chris3069/Grossprojekt_Foehn/README.md

# Großprojekt Föhn

Für das Fritz-Felsenstein-Haus aus Königsbrunn wurde das bestehende Projekt **Föhn** erweitert und verbessert. 
Der Föhn ermöglicht Rollstuhlfahrern und gehbehinderte Personen und Kindern sich selbständig die Haare zu föhnen. 

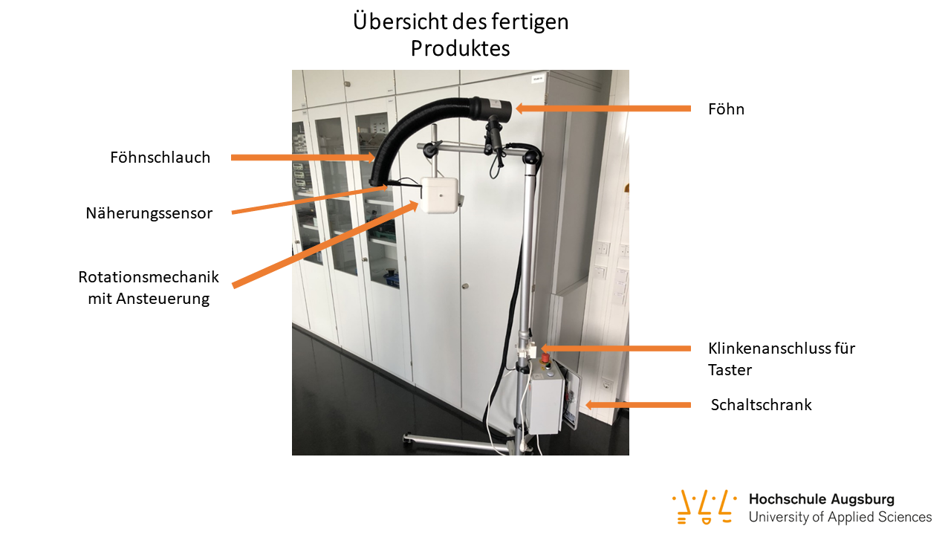
[picture p1: Dokumentation/Abschlusspräsentation Föhn 21/Folie6.PNG]
Föhn Übersicht


## Projektübernahme 
Die Vorgängergruppe hat den Föhn mit einem Raspberry Pi gesteuert. Die lange Vorbereitungszeit bis das System bereit war, hat zu lange gedauert. \
Es konnte nicht eingesetzt werden, da es nicht den geltenden EMV-Bestimmungen entsprach. Die Software des Föhns hatte Fehler und konnte nach wenigen Minuten nicht wieder benutzt werden. 

## Projektziele

- Requirements Engineering um Anforderungen und Projektziel besser abzustimmen. 
- Lasten- und Pflichtenheft erstellen 
- Austausch der Steuerung durch ein uController, STM32F446RE um Vorbereitungszeit zu verringern 
- Sicherer störungsfreier und konstanter Föhnbetrieb
- Universelle HMI-Schnittstelle um Taster austauschen zu können
- Drehbewegung des Föhns um gleichmäßiges Föhnen zu ermöglichen und Brandstellen zu vermeiden
- Bessere Sensorik verwenden 

## Software

Die Initialisierung wurde die CubeMx generiert. Die Software wurde mithilfe des STM HAL geschrieben. 

Die Software wurde mithilfe von UML Diagrammen dokumentiert. 
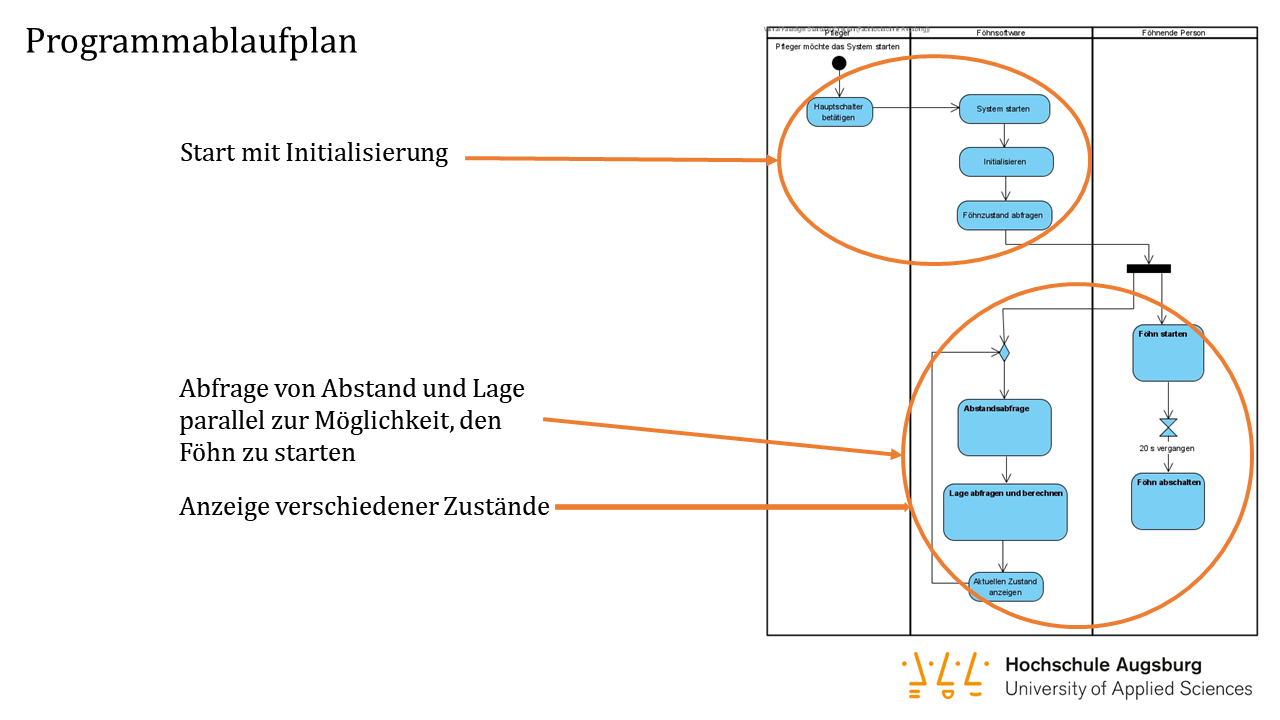
[picture p2: Dokumentation/Abschlusspräsentation Föhn 21/Folie10.PNG]
UML Diagramm Programmablaufplan
Eines der wichtigsten Diagramme zeigt den Programmablaufplan. 

## Motoransteuerung 

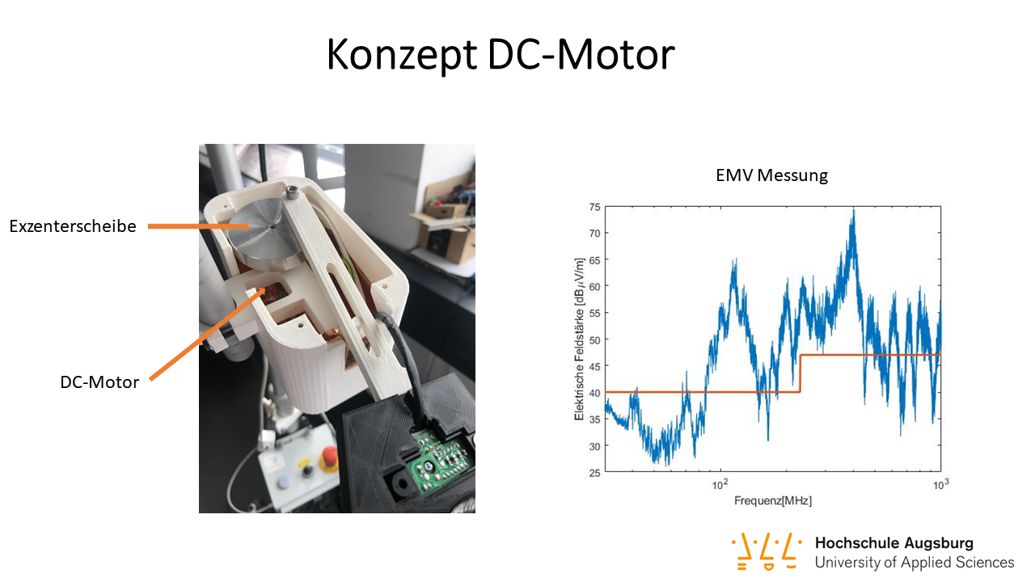
[picture p3: Dokumentation/Abschlusspräsentation Föhn 21/Folie13.PNG]
DC-Motor
Eine Anforderung der Leitung war einen DC-Motor zu verwenden. Es wurde eine Mechanik und auch eine elektrische sowie Software Ansteuerung entwickelt. 
Die EMV Werte lagen über den erlaubten Grenzwerten. Es wurde eine Lösung mithilfe eines Servo-Motors gewählt. Die EMV-Messwerte lagen danach unterhalb der Grenzwerte. 
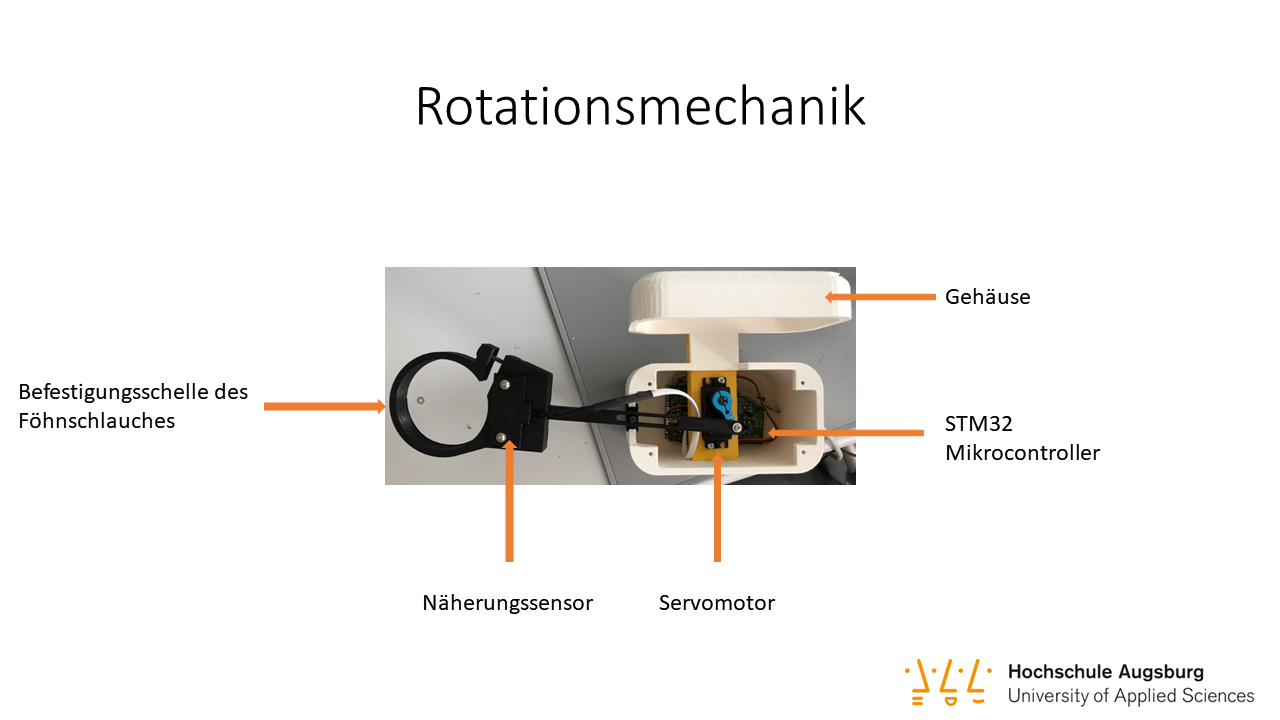
[picture p4: Dokumentation/Abschlusspräsentation Föhn 21/Folie7.PNG]
Servo-Motor


## Zeitungsartikel
Auch in der Zeitung wurde über das Projekt und den Föhn berichtet. 

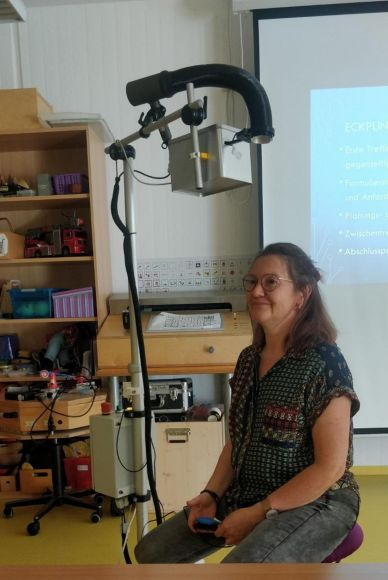
[picture p5: Dokumentation/Foehn_Anwendung.png]
Föhn Anwendung


[Staz Zeitungsartikel](https://www.staz.de/region/koenigsbrunn/lokales/tastern-mikrocomputern-studenten-entwickeln-spiele-alltagsgegenstaende-fuer-koerperbehinderte-id231747.html)
