chris3069/Grossprojekt_Foehn/Dokumentation/UML-Diagramme/README.md

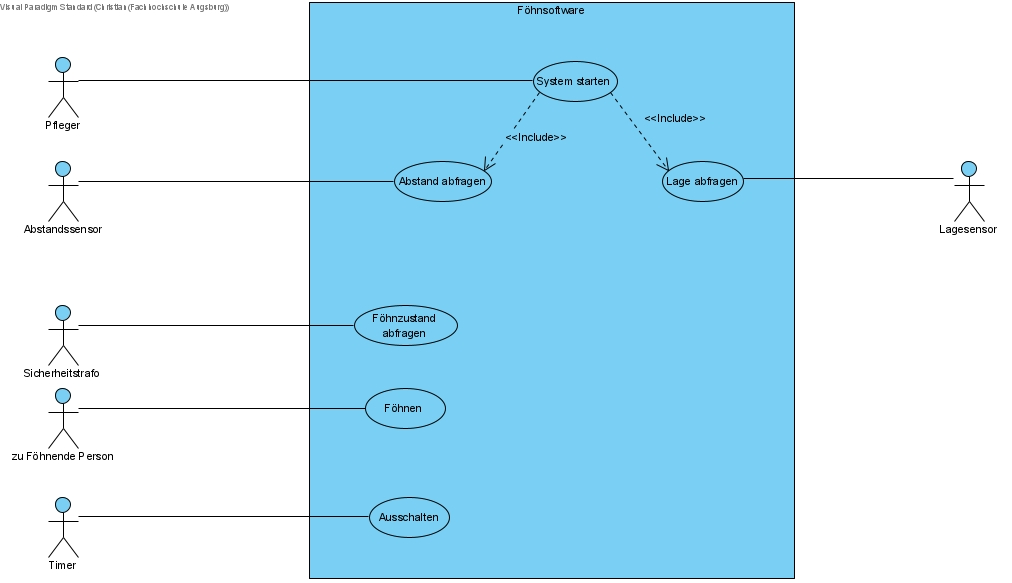
[picture p6: Dokumentation/UML-Diagramme/Use_Case_Diagramm_Foehn.jpg]
Use Case Diagramm


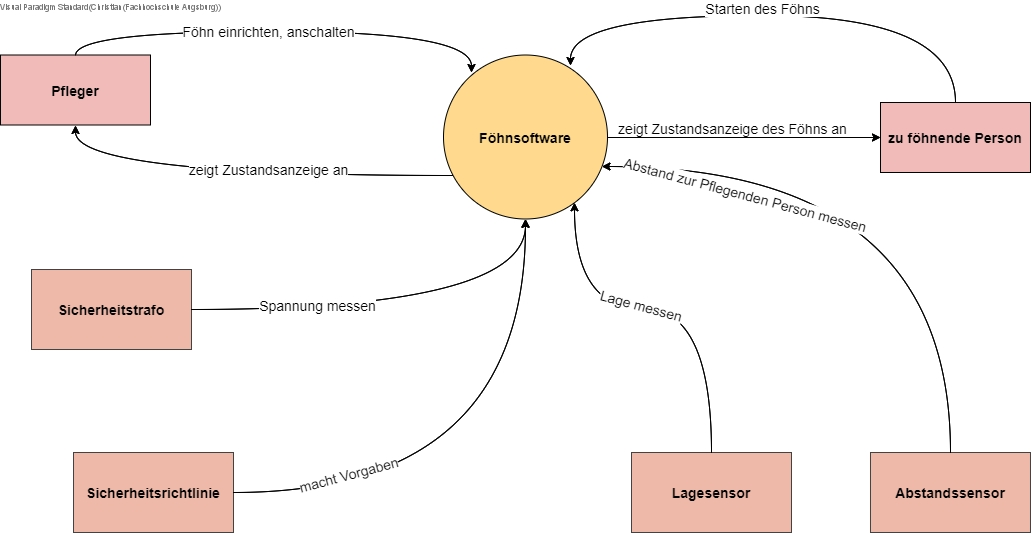
[picture p7: Dokumentation/UML-Diagramme/Kontextdiagramm.jpg]
Kontextdiagramm


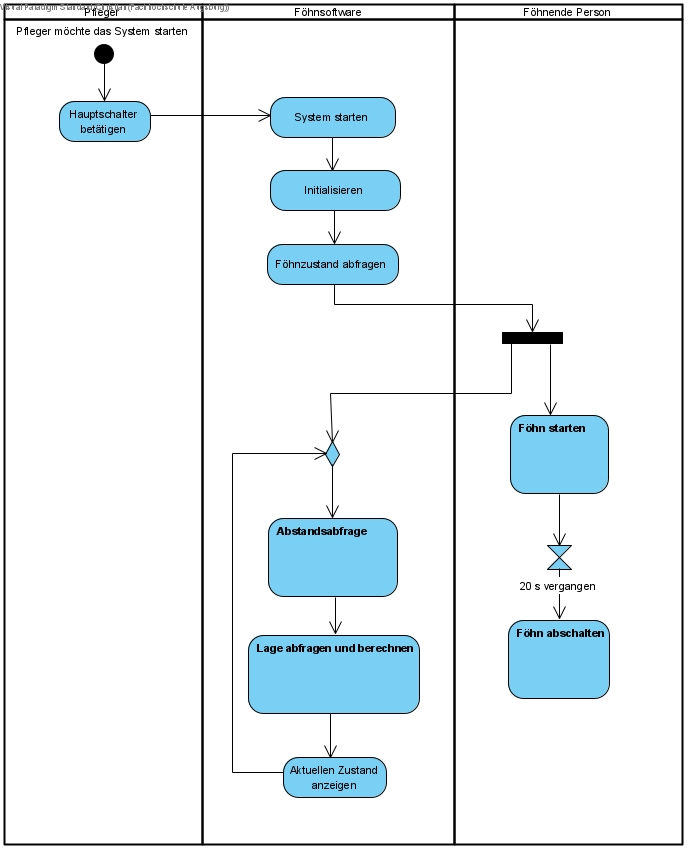
[picture p8: Dokumentation/UML-Diagramme/Aktivitaetsdiagramm_main.jpg]
Main Loop Aktivitaetsdiagramm


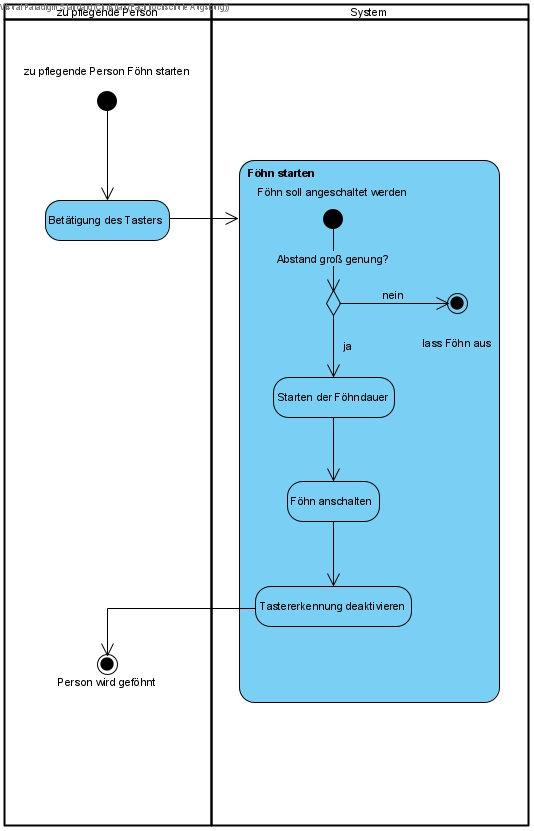
[picture p9: Dokumentation/UML-Diagramme/Aktivitaetsdiagramm_Foehn_starten.jpg]
Foehn starten Aktivitaetsdiagramm


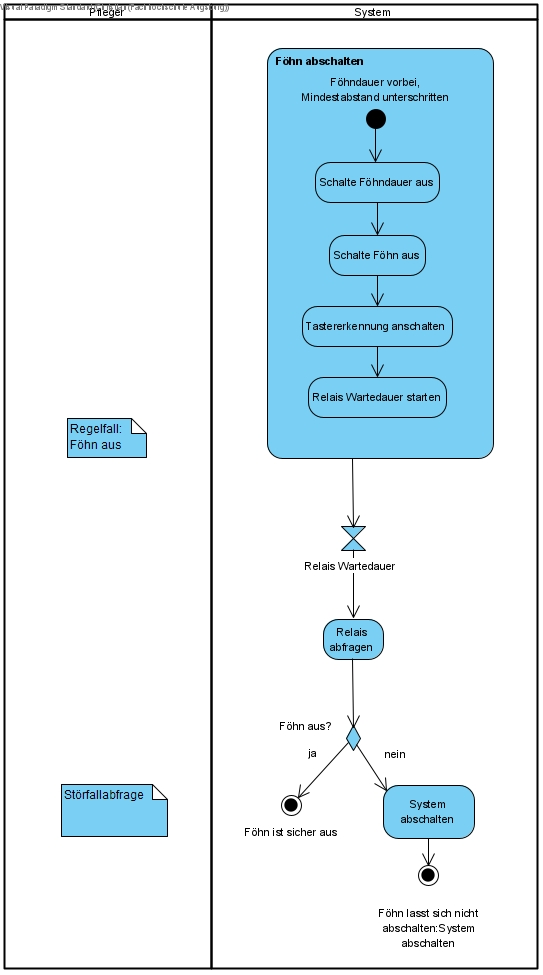
[picture p10: Dokumentation/UML-Diagramme/Aktivitätsdiagramm_Foehn_Abschalten.jpg]
Foehn abschalten Aktivitaetsdiagramm


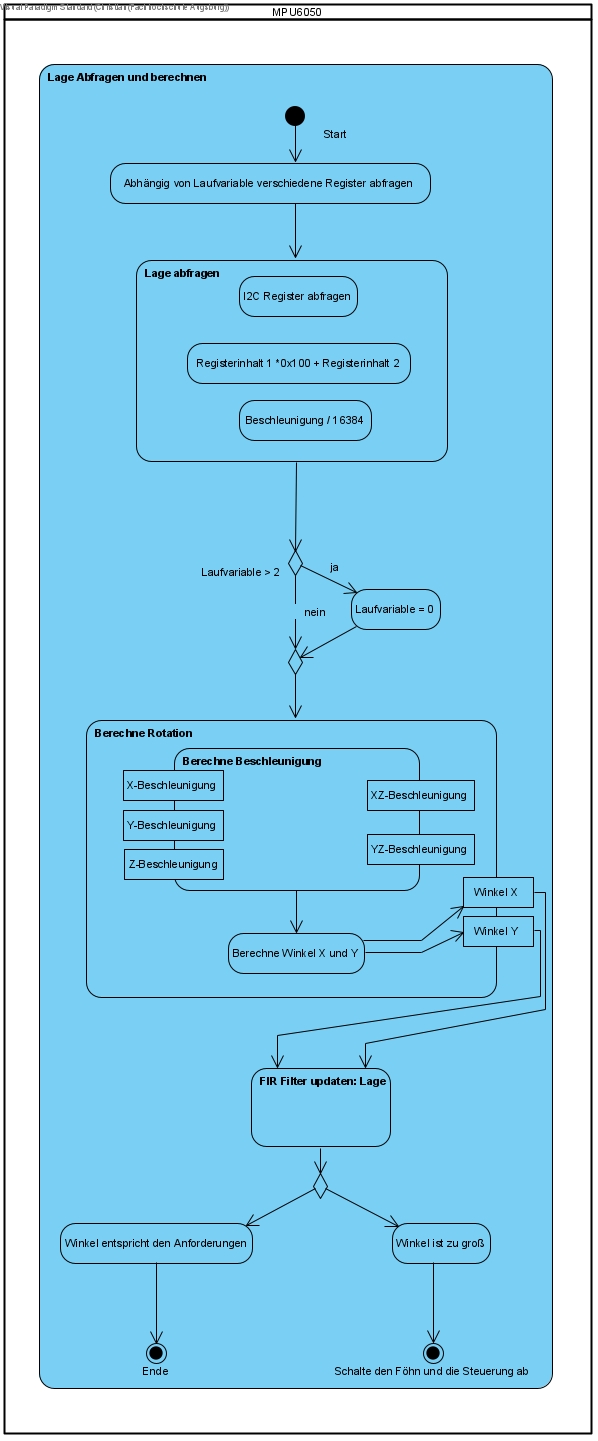
[picture p11: Dokumentation/UML-Diagramme/Swinlane_Proposal_Process.jpg]
Lage abfragen


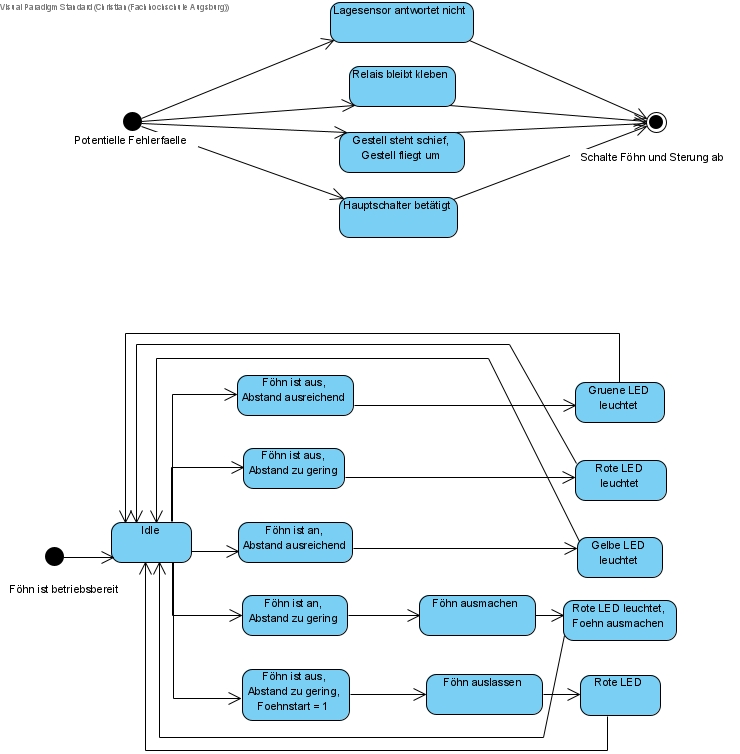
[picture p12: Dokumentation/UML-Diagramme/Zustandsdiagramm.jpg]
allgemeine Zustandsabfrage


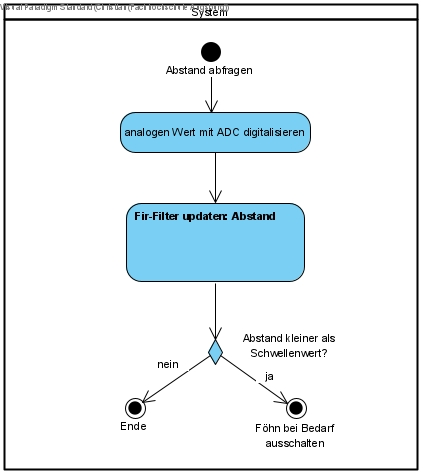
[picture p13: Dokumentation/UML-Diagramme/Aktivitaetsdiagramm_abstandsabfrage.jpg]
Aktivitaetsdiagramm


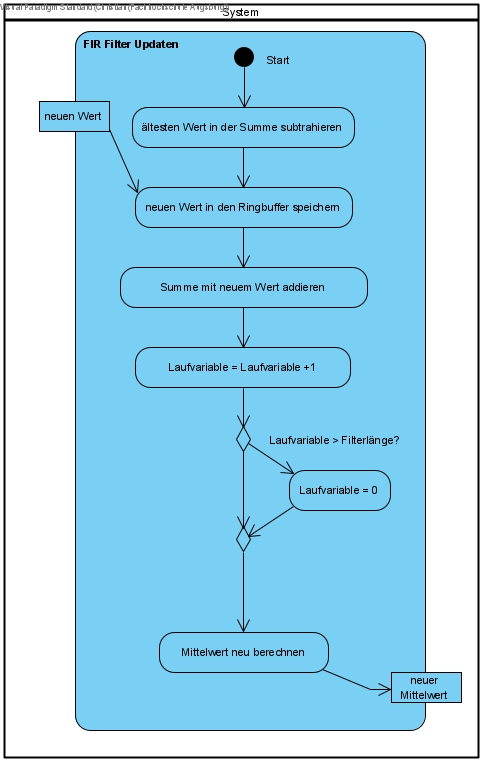
[picture p14: Dokumentation/UML-Diagramme/Aktivitaetsdiagramm_FIR.jpg]
FIR Filter
