chris3069/Grossprojekt_Foehn/Dokumentation/Abschlusspräsentation Föhn 21/Folie3.PNG

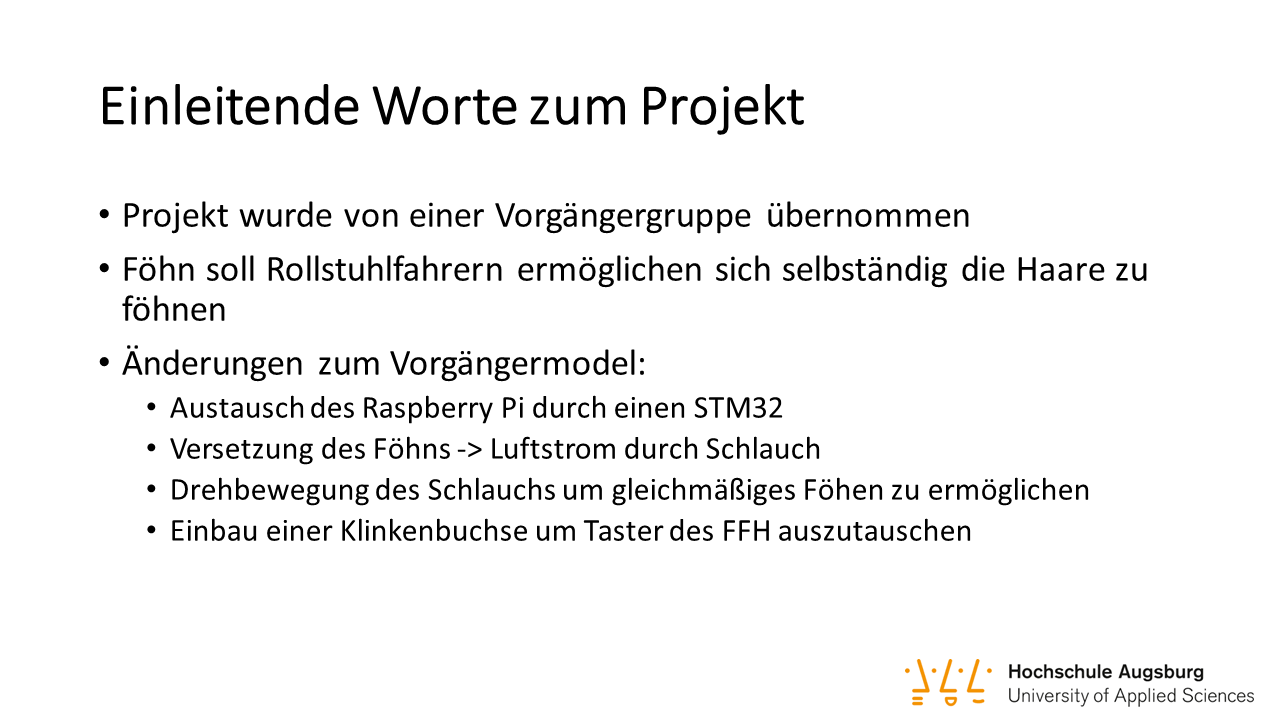
Dokumentation/Abschlusspräsentation Föhn 21/Folie3.PNG
