chris3069/Grossprojekt_Foehn/Dokumentation/Abschlusspräsentation Föhn 21/Folie9.PNG

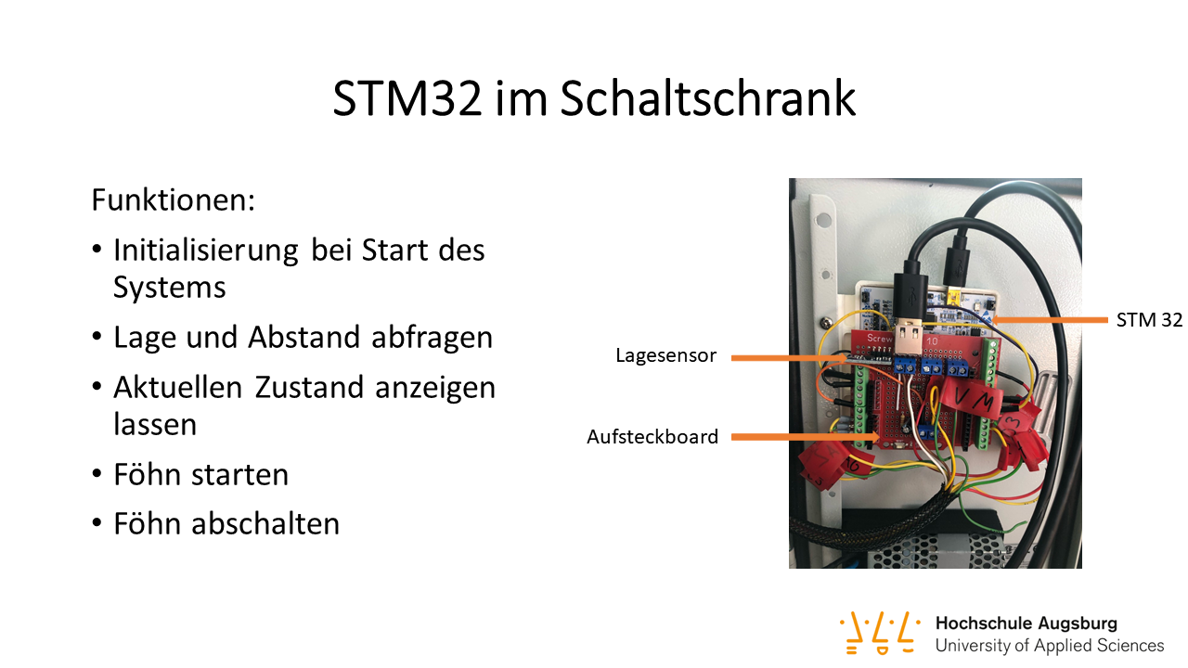
Dokumentation/Abschlusspräsentation Föhn 21/Folie9.PNG
