chris3069/Grossprojekt_Foehn/Dokumentation/Abschlusspräsentation Föhn 21/Folie11.PNG

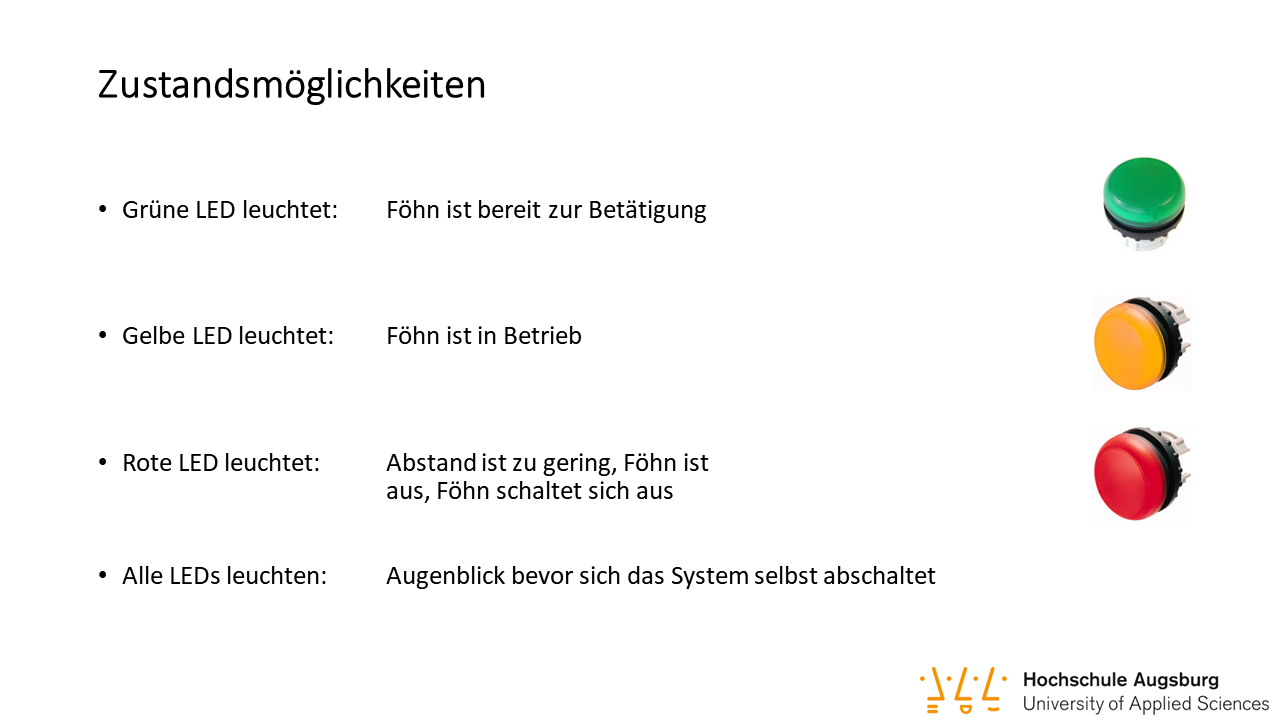
Dokumentation/Abschlusspräsentation Föhn 21/Folie11.PNG
