chris3069/Grossprojekt_Foehn/Dokumentation/Abschlusspräsentation Föhn 21/Folie12.PNG

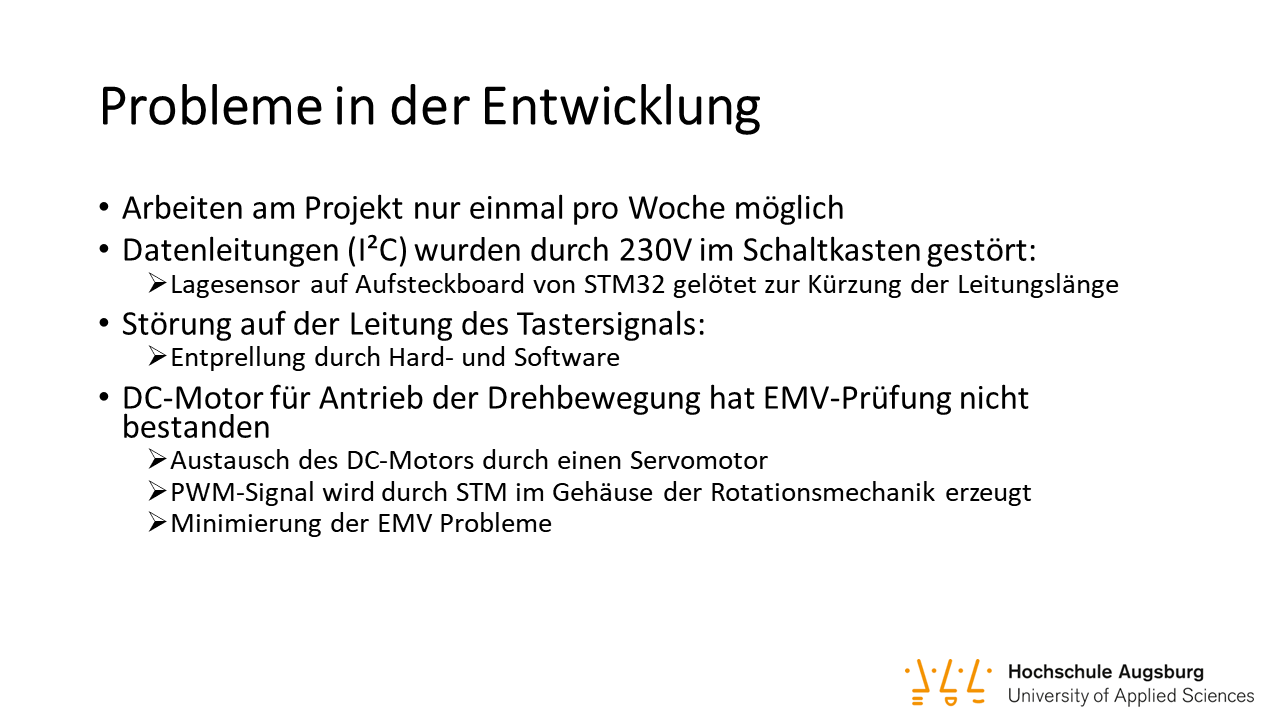
Dokumentation/Abschlusspräsentation Föhn 21/Folie12.PNG
