chris3069/Grossprojekt_Foehn/Matlab File/Screenshot from 2021-07-14 14-53-59.png

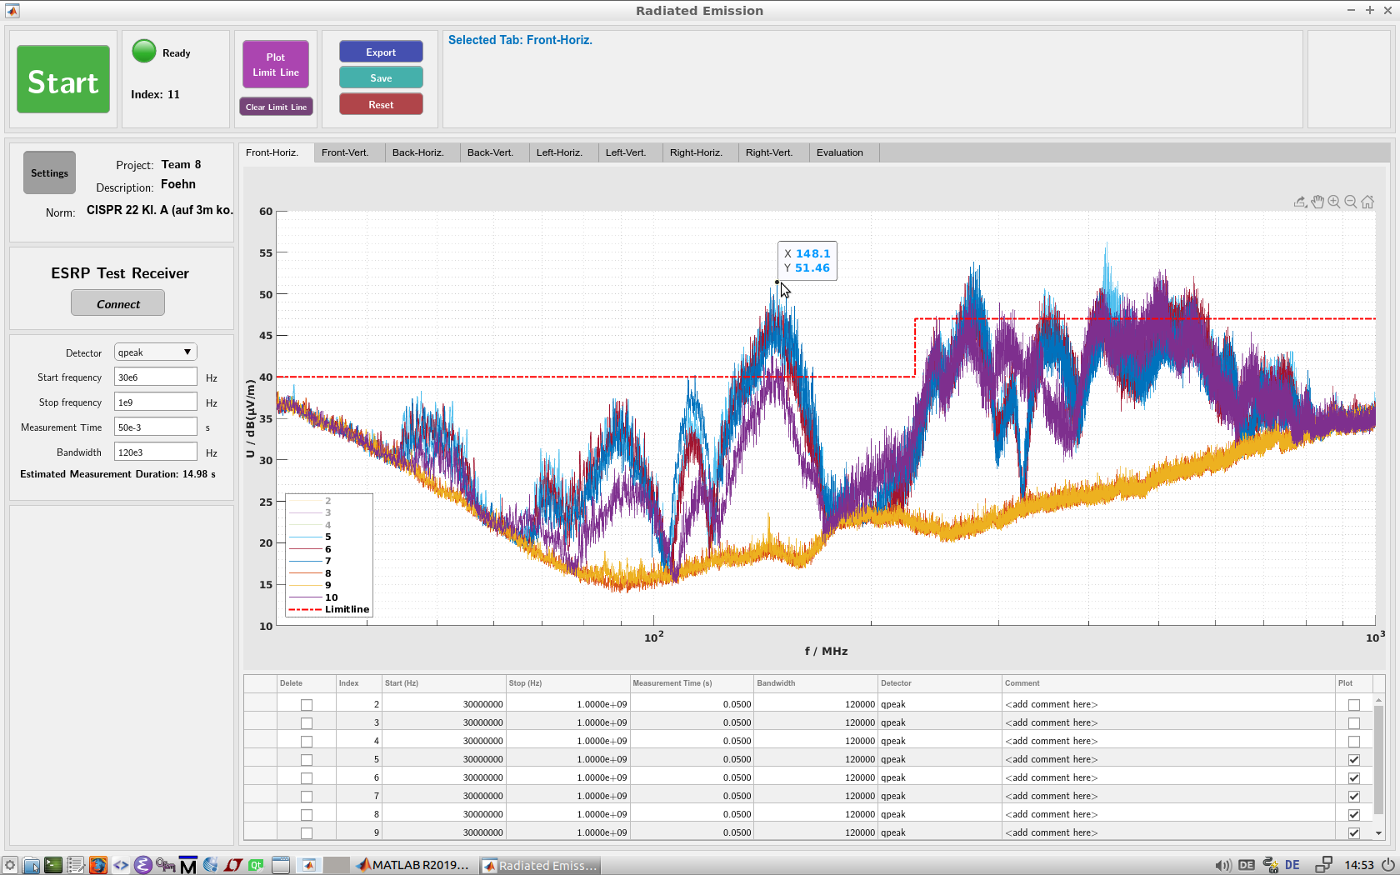
Matlab File/Screenshot from 2021-07-14 14-53-59.png
