chris3069/Grossprojekt_Foehn/Source_Codes/EMV-Proramm/Src/main.c

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
/* Includes ------------------------------------------------------------------*/
#include "main.h"
#include "adc.h"
#include "i2c.h"
#include "tim.h"
#include "usart.h"
#include "gpio.h"

/* USER CODE BEGIN Includes */
#include "stm32f4xx_it.h"
#include "main.h"
#include <stdio.h>
#include <string.h>
#include "servo.h"
#include "firFilter.h"
#include "MPU6050.h"
/* USER CODE END Includes */


/* USER CODE BEGIN PV */
//volatile uint32_t ms_tick;
bool tick10ms = 0;
bool tick1500ms = 0;
bool tick50ms = 0;

bool foehnzustand = 0;
uint8_t spannung = 0;
bool abstandOK = 1;


uint8_t mittlererAbstand;
double mittlererWinkelY;
double mittlererWinkelX;

/* USER CODE END PV */

void SystemClock_Config(void);
/* USER CODE BEGIN PFP */

void foehnabschalten(void);
void foehnStarten(void);
void stickyRelais(void);		// Relais bleibt kleben
void abstandabfragen(void);
bool abstandInOrdnung(uint8_t *);

void initialisierung(void);

void lED_Ansteuerung(void);					// setze AMPEL LED
void lagefunktion(void);						// Funktion beinhaltet alle Funktionen, um die Lage abzufragen
bool abstandsfunktion(uint8_t *);		// Funktion beinhaltet alle Funktionen, um den Abstand abzufragen
void zustandsabfrage(void);

/* USER CODE END PFP */

/**
  * @brief  The application entry point.
  * @retval int
  */
int main(void)
{
  /* MCU Configuration--------------------------------------------------------*/

  /* Reset of all peripherals, Initializes the Flash interface and the Systick. */
  HAL_Init();

  /* Configure the system clock */
  SystemClock_Config();

  /* USER CODE BEGIN SysInit */
__disable_irq(); // Tastendruck noch sperren, bis initialisiert wurde
  /* USER CODE END SysInit */

  /* Initialize all configured peripherals */
  MX_GPIO_Init();
  MX_USART2_UART_Init();
  MX_TIM11_Init();
  MX_ADC1_Init();
  MX_TIM2_Init();
  MX_TIM13_Init();
  MX_I2C3_Init();
  /* USER CODE BEGIN 2 */

	initialisierung();
__enable_irq(); // Tastendruck ab jetzt erlauben

				foehnStarten();

  /* USER CODE END 2 */

  /* Infinite loop */
  /* USER CODE BEGIN WHILE */
  while (1)
  {

		if(tick10ms == true) 		// Abfrage Flag ist gestetzt
		{
			tick10ms = false;
			zustandsabfrage();
		}

		if(tick1500ms == true)
		{
			//uint8_t ausgabebuffer[30];	// Speicher anlegen
			tick1500ms = false;
			if (foehnzustand == 0)
			{
			//foehnStarten();
			}
//			else
//			{
//				foehnabschalten();
//			}
//			sprintf((char*)ausgabebuffer, "Abstand: %d \r\n", mittlererAbstand);
//			HAL_UART_Transmit_IT(&huart2, ausgabebuffer, strlen((char*)ausgabebuffer));
//

			//sprintf((char*)ausgabebuffer, "X-Beschleunigung: %.2f \t Y-Beschleunigung: %.2f \t Z-Beschleunigung: %.2f \n\r X-Winkel: %.2f \t Y-Winkel: %.2f\r\n", [0], lage[1], lage[2], mittlererWinkelX, mittlererWinkelY);
//			sprintf((char*)ausgabebuffer, "X-Winkel: %.2f \t Y-Winkel: %.2f\r\n", mittlererWinkelX, mittlererWinkelY);
//			HAL_UART_Transmit_IT(&huart2, ausgabebuffer, strlen((char*)ausgabebuffer));
		}
//
//		if(tick50ms == true)
//		{
//			tick50ms = false;
//
////			if(foehnzustand == 1)
////			{
//				servoDegtoDeg(100,170);
//			}
//
//			if(foehnzustand == 0)
//			{
//				servoReset();
//			}

		//}

    /* USER CODE END WHILE */

    /* USER CODE BEGIN 3 */
//  }
  /* USER CODE END 3 */
}

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
/* USER CODE BEGIN 4 */
void HAL_UART_TxCpltCallback(UART_HandleTypeDef *huart)
{
	__NOP();
}

void initialisierung(void)
{
	TIM11->SR = 0;
	TIM13->SR = 0;
	InitMPU6050();		// Abbruchbedingung, falls MPU nicht erkannt wird
	stickyRelais(); // Falls Relais kleben bleibt, sofort wieder aus machen
	// startPWM2();
}

void zustandsabfrage()
{
	//abstandsfunktion(&spannung);	// Abstand abfragen
	lED_Ansteuerung();						// setze AMPEL LED
	lagefunktion();								// Lage abfragen
}

void lED_Ansteuerung()
{
	if(abstandOK == 1 && foehnzustand == 0)															// Ausgangslage Gruene LED leuchtet
	{
		HAL_GPIO_WritePin(LED_R_GPIO_Port, LED_R_Pin, GPIO_PIN_RESET);		//Rote LED
		HAL_GPIO_WritePin(LED_G_GPIO_Port, LED_G_Pin, GPIO_PIN_SET); 			//Gruene LED
		HAL_GPIO_WritePin(LED_Y_GPIO_Port, LED_Y_Pin, GPIO_PIN_RESET); 		//GELBE LED
	}
	else if(abstandOK == 0 && foehnzustand == 0)												// Abstand zu gering Rote LED
	{
		HAL_GPIO_WritePin(LED_R_GPIO_Port, LED_R_Pin, GPIO_PIN_SET);			//Rote LED
		HAL_GPIO_WritePin(LED_G_GPIO_Port, LED_G_Pin, GPIO_PIN_RESET); 		//Gruene LED
		HAL_GPIO_WritePin(LED_Y_GPIO_Port, LED_Y_Pin, GPIO_PIN_RESET); 		//GELBE LED
	}
	else if(abstandOK == 1 && foehnzustand == 1)												// Foehn an und Abstand OK
	{
		HAL_GPIO_WritePin(LED_R_GPIO_Port, LED_R_Pin, GPIO_PIN_RESET); 		//Rote LED
		HAL_GPIO_WritePin(LED_G_GPIO_Port, LED_G_Pin, GPIO_PIN_RESET); 		//Gruene LED
		HAL_GPIO_WritePin(LED_Y_GPIO_Port, LED_Y_Pin, GPIO_PIN_SET);			//Gelbe LED
	}
	else if(abstandOK == 0 && foehnzustand == 1)												// Foehn an und Abstand zu gering
	{
		HAL_GPIO_WritePin(LED_R_GPIO_Port, LED_R_Pin, GPIO_PIN_SET); 			//Rote LED
		HAL_GPIO_WritePin(LED_G_GPIO_Port, LED_G_Pin, GPIO_PIN_RESET); 		//Gruene LED
		HAL_GPIO_WritePin(LED_Y_GPIO_Port, LED_Y_Pin, GPIO_PIN_RESET);		//Gelbe LED
//		foehnabschalten();																								// Foehn korrekt ausschalten
	}
}

void lagefunktion(void) 																							// Funktion beinhaltet alle Funktionen, um die Lage abzufragen
{
	// Anlegen und initialisieren von Speicher
	static FIRFilter lagemessungenX = {{0}, 0, 0};
	static FIRFilter lagemessungenY = {{0}, 0, 0};
	static double lage[5];

	// Lageberechnung
	foehnlageberechnung(lage);
	mittlererWinkelX = FIRFilter_Update(&lagemessungenX, lage[3]);
	mittlererWinkelY = FIRFilter_Update(&lagemessungenY, lage[4]);

	if (foehnWinkelBerechnung(mittlererWinkelX, mittlererWinkelY) == 1)
	{
		HAL_GPIO_WritePin(LED_R_GPIO_Port, LED_R_Pin, GPIO_PIN_SET); 			//Rote LED
		HAL_GPIO_WritePin(LED_G_GPIO_Port, LED_G_Pin, GPIO_PIN_SET); 			//Gruene LED
		HAL_GPIO_WritePin(LED_Y_GPIO_Port, LED_Y_Pin, GPIO_PIN_SET);			//Gelbe LED
		//Error_Handler();
	}
}

bool abstandsfunktion(uint8_t *spannung)															// Funktion beinhaltet alle Funktionen, um den Abstand abzufragen
{
	static FIRFilter abstand = {{0}, 0, 0};															//Anlegen von Speicher
	abstandsMessung(spannung);																					// Abstand abfragen
	mittlererAbstand = FIRFilter_Update(&abstand, (double)*spannung);		// Abstand filtern, Mittleren Abstand berechnen
	return abstandOK = abstandInOrdnung(&mittlererAbstand);
}

void stickyRelais(void)
{
	bool aktuellerZustand = HAL_GPIO_ReadPin(Relais_Spannung_GPIO_Port, Relais_Spannung_Pin); //Relais Zustand abfragen

//	if (foehnzustand == 0)														// PWM von Servo ausschalten
//	{
//			//HAL_TIM_PWM_Stop(&htim2, TIM_CHANNEL_2);
//	}
	if(aktuellerZustand == 0 || aktuellerZustand == foehnzustand)
	{
		return;
	}
	else
	{
		const uint8_t ausgabebuffer[] = "F�hn ist noch an";
		HAL_UART_Transmit(&huart2, (uint8_t *)ausgabebuffer, strlen((char*)ausgabebuffer), 5);
		Error_Handler(); 																										// NOTAUS
	}
}

bool abstandInOrdnung(uint8_t *abstand)
{
	if (*abstand > 175)
	{ // Abstand <10 cm
		return false;
	}
	else
		// Abstand > 10cm
	{
		return true;
	}
}

void foehnStarten()
{
	if(abstandOK == 1)
	{
	HAL_NVIC_DisableIRQ(EXTI0_IRQn);		// Taster Interrupt ausstellen
	HAL_TIM_Base_Stop_IT(&htim13);
	// Tim 11	Reinitialisieren
	TIM11->CNT = 0;
	HAL_TIM_Base_Start_IT(&htim11);		// starte Timer
	foehnzustand = 1;
	HAL_GPIO_WritePin(K3_Foehn_GPIO_Port, K3_Foehn_Pin, GPIO_PIN_RESET); // Foehn anschalten
		//HAL_TIM_PWM_Start(&htim2, TIM_CHANNEL_2); 		//Servobetaetigen
	}
}

void foehnabschalten()
{
//		HAL_GPIO_WritePin(K3_Foehn_GPIO_Port, K3_Foehn_Pin, GPIO_PIN_SET); // foehn abschalten
//		HAL_TIM_Base_Stop_IT(&htim11);								// Schalte Timer aus
//		foehnzustand = 0;
//		// starte Timer 13, um Sticky Relay abzufragen
//		TIM13->CNT = 0;
//		HAL_TIM_Base_Start_IT(&htim13);

//			while (HAL_NVIC_GetPendingIRQ(EXTI0_IRQn))		// Taster Interrupt starten, Pending Bit = 0 setzen
//		{
//		__HAL_GPIO_EXTI_CLEAR_IT(EXTI_PIN_MASK);
//			HAL_NVIC_ClearPendingIRQ(EXTI0_IRQn);			// falls Taster waehrend foehnen betaetigt wurde, Pending Bit loeschen
//		}

}


void 	HAL_TIM_PeriodElapsedCallback(TIM_HandleTypeDef *htim) 		//Aufruf, wenn Periode von Timer vorbei ist
{
	if(htim == &htim11) // Foehndauer vorbei
	{
		foehnabschalten();
	}
	if(htim == &htim13) // Dauer nach Foehnen vorbei -> Relais abfragen
	{
		HAL_TIM_Base_Stop_IT(&htim13);								// Schalte Timer aus
		stickyRelais();
	}
}

void HAL_GPIO_EXTI_Callback(uint16_t GPIO_Pin)
{
	HAL_Delay(1);

	if(	HAL_GPIO_ReadPin(Taster_GPIO_Port, Taster_Pin) == 0)
	{
		return;
	}
	else
	{
	foehnStarten();
	}
}

void HAL_ADC_ConvCpltCallback(ADC_HandleTypeDef* hadc)
{
	spannung = HAL_ADC_GetValue(&hadc1);
	HAL_ADC_Stop_IT(&hadc1);
}

/* USER CODE END 4 */
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
