chris3069/Grossprojekt_Foehn/Source_Codes/EMV-Proramm/Inc/main.h

#define K4_Selbst_Pin GPIO_PIN_0
#define K4_Selbst_GPIO_Port GPIOC
#define K3_Foehn_Pin GPIO_PIN_1
#define K3_Foehn_GPIO_Port GPIOC
#define Taster_Pin GPIO_PIN_0
#define Taster_GPIO_Port GPIOA
#define Taster_EXTI_IRQn EXTI0_IRQn
#define Servo_Pin GPIO_PIN_1
#define Servo_GPIO_Port GPIOA
#define Abstandsmessung_Pin GPIO_PIN_4
#define Abstandsmessung_GPIO_Port GPIOA
#define Servo_2_Pin GPIO_PIN_5
#define Servo_2_GPIO_Port GPIOA
#define Relais_Spannung_Pin GPIO_PIN_7
#define Relais_Spannung_GPIO_Port GPIOA
#define K2_Haupt_Pin GPIO_PIN_0
#define K2_Haupt_GPIO_Port GPIOB
#define LED_Y_Pin GPIO_PIN_10
#define LED_Y_GPIO_Port GPIOA
#define LED_G_Pin GPIO_PIN_3
#define LED_G_GPIO_Port GPIOB
#define LED_R_Pin GPIO_PIN_5
#define LED_R_GPIO_Port GPIOB
