chris3069/Grossprojekt_Foehn/Source_Codes/EMV-Proramm/Src/i2c.c

/**
  ******************************************************************************
  * @file    i2c.c
  * @brief   This file provides code for the configuration
  *          of the I2C instances.
  ******************************************************************************
  * @attention
  *
  * <h2><center>&copy; Copyright (c) 2021 STMicroelectronics.
  * All rights reserved.</center></h2>
  *
  * This software component is licensed by ST under BSD 3-Clause license,
  * the "License"; You may not use this file except in compliance with the
  * License. You may obtain a copy of the License at:
  *                        opensource.org/licenses/BSD-3-Clause
  *
  ******************************************************************************
  */

/* Includes ------------------------------------------------------------------*/
#include "i2c.h"

/* USER CODE BEGIN 0 */
	//	static HAL_StatusTypeDef ret;

		
//const uint8_t MCP9808 = 0x18 << 1;
////const uint8_t MCP9808 = 0x28 << 1;
//const uint8_t REG_TEMP = 0x05;	//Temperatur Register
//const uint8_t REG_RES = 0x08; 	//Resolution Register
//const uint8_t RES_VAL = 0x03;	// Resolution = 0.0625°C

//uint16_t tempabfragen(double *buf);


//const uint8_t MPU6050 = 0xD0; // 7 Bit Adresse bereits
//const uint8_t power_mgmt_1 = 0x6B;
//const uint8_t power_mgmt_2 = 0x6C;
//const uint8_t ACCEL_XOUT = 0x3B;
//const uint8_t ACCEL_YOUT = 0x3D;
//const uint8_t ACCEL_ZOUT = 0x3F;

//const double pi = 3.14159265358979323846;

//const int8_t maxDrehungX = 10; 
//const int8_t maxDrehungY = 10; 
//const int8_t minDrehungX = -10; 
//const int8_t minDrehungY = -10; 


// MPU6050

		
/* USER CODE END 0 */

I2C_HandleTypeDef hi2c3;

/* I2C3 init function */
void MX_I2C3_Init(void)
{

  hi2c3.Instance = I2C3;
  hi2c3.Init.ClockSpeed = 100000;
  hi2c3.Init.DutyCycle = I2C_DUTYCYCLE_2;
  hi2c3.Init.OwnAddress1 = 0;
  hi2c3.Init.AddressingMode = I2C_ADDRESSINGMODE_7BIT;
  hi2c3.Init.DualAddressMode = I2C_DUALADDRESS_DISABLE;
  hi2c3.Init.OwnAddress2 = 0;
  hi2c3.Init.GeneralCallMode = I2C_GENERALCALL_DISABLE;
  hi2c3.Init.NoStretchMode = I2C_NOSTRETCH_DISABLE;
  if (HAL_I2C_Init(&hi2c3) != HAL_OK)
  {
    Error_Handler();
  }
}

void HAL_I2C_MspInit(I2C_HandleTypeDef* i2cHandle)
{

  GPIO_InitTypeDef GPIO_InitStruct = {0};
  if(i2cHandle->Instance==I2C3)
  {
    __HAL_RCC_GPIOA_CLK_ENABLE();
    __HAL_RCC_GPIOB_CLK_ENABLE();
    /**I2C3 GPIO Configuration
    PA8     ------> I2C3_SCL
    PB4     ------> I2C3_SDA
    */
    GPIO_InitStruct.Pin = GPIO_PIN_8;
    GPIO_InitStruct.Mode = GPIO_MODE_AF_OD;
    GPIO_InitStruct.Pull = GPIO_PULLUP;
    GPIO_InitStruct.Speed = GPIO_SPEED_FREQ_VERY_HIGH;
    GPIO_InitStruct.Alternate = GPIO_AF4_I2C3;
    HAL_GPIO_Init(GPIOA, &GPIO_InitStruct);

    GPIO_InitStruct.Pin = GPIO_PIN_4;
    GPIO_InitStruct.Mode = GPIO_MODE_AF_OD;
    GPIO_InitStruct.Pull = GPIO_PULLUP;
    GPIO_InitStruct.Speed = GPIO_SPEED_FREQ_VERY_HIGH;
    GPIO_InitStruct.Alternate = GPIO_AF4_I2C3;
    HAL_GPIO_Init(GPIOB, &GPIO_InitStruct);

    /* I2C3 clock enable */
    __HAL_RCC_I2C3_CLK_ENABLE();

    /* I2C3 interrupt Init */
    HAL_NVIC_SetPriority(I2C3_EV_IRQn, 1, 0);
    HAL_NVIC_EnableIRQ(I2C3_EV_IRQn);
    HAL_NVIC_SetPriority(I2C3_ER_IRQn, 0, 0);
    HAL_NVIC_EnableIRQ(I2C3_ER_IRQn);
  }
}

void HAL_I2C_MspDeInit(I2C_HandleTypeDef* i2cHandle)
{

  if(i2cHandle->Instance==I2C3)
  {
    /* Peripheral clock disable */
    __HAL_RCC_I2C3_CLK_DISABLE();

    /**I2C3 GPIO Configuration
    PA8     ------> I2C3_SCL
    PB4     ------> I2C3_SDA
    */
    HAL_GPIO_DeInit(GPIOA, GPIO_PIN_8);

    HAL_GPIO_DeInit(GPIOB, GPIO_PIN_4);

    /* I2C3 interrupt Deinit */
    HAL_NVIC_DisableIRQ(I2C3_EV_IRQn);
    HAL_NVIC_DisableIRQ(I2C3_ER_IRQn);
  }
}

/************************ (C) COPYRIGHT STMicroelectronics *****END OF FILE****/
